charm-lab/Tapebot-Code/TapeBot PCB Files - Spencer/BoardImage.jpg

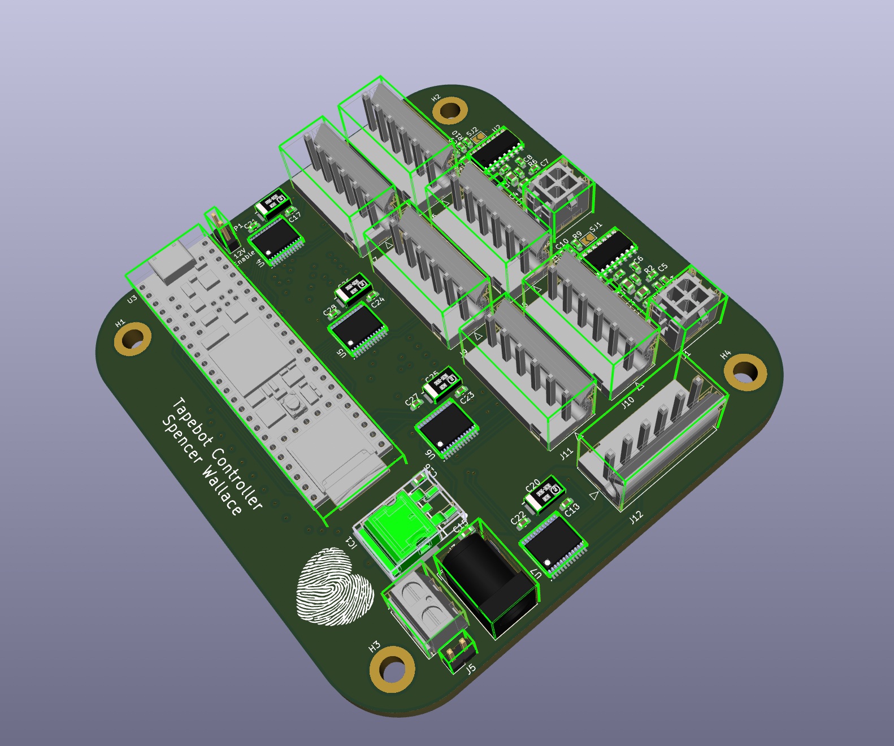
TapeBot PCB Files - Spencer/BoardImage.jpg
