charm-lab/Tapebot-Code/TapeBot PCB Files - Spencer/TapeBot.jpg

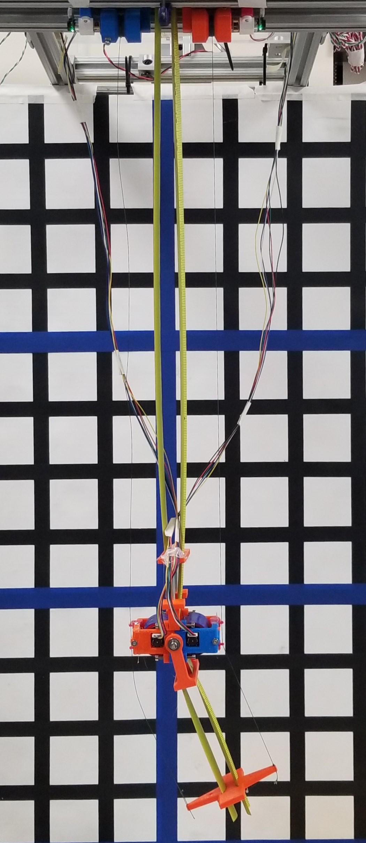
TapeBot PCB Files - Spencer/TapeBot.jpg
