charm-lab/Tapebot-Code/TapeBot PCB Files - Spencer/TapeBotLibraries/DCJ200-10-A-XX-X_REVA/DCJ200-10-A-XX-X_REVA.step

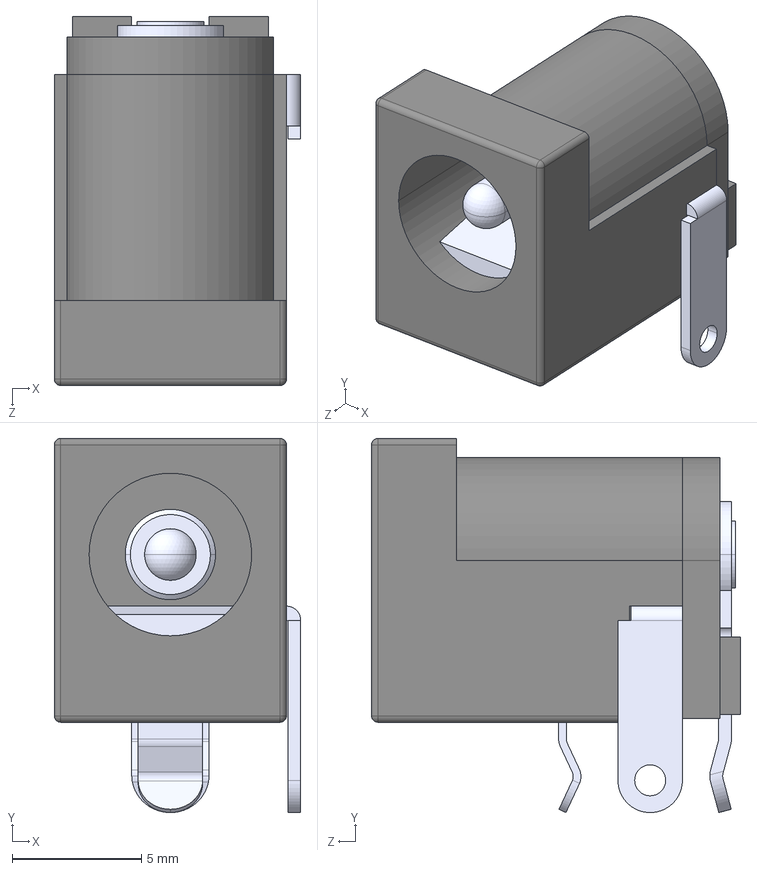
[picture p4: CAD file, 2023-02-14]
TapeBot PCB Files - Spencer/TapeBotLibraries/DCJ200-10-A-XX-X_REVA/DCJ200-10-A-XX-X_REVA.step
9.55 x 14.5 x 14.3 mm
