charm-lab/Tapebot-Code/TapeBot PCB Files - Spencer/TapeBotLibraries/LIB_09-65-2068/09-65-2068/3D/09-65-2068.stp

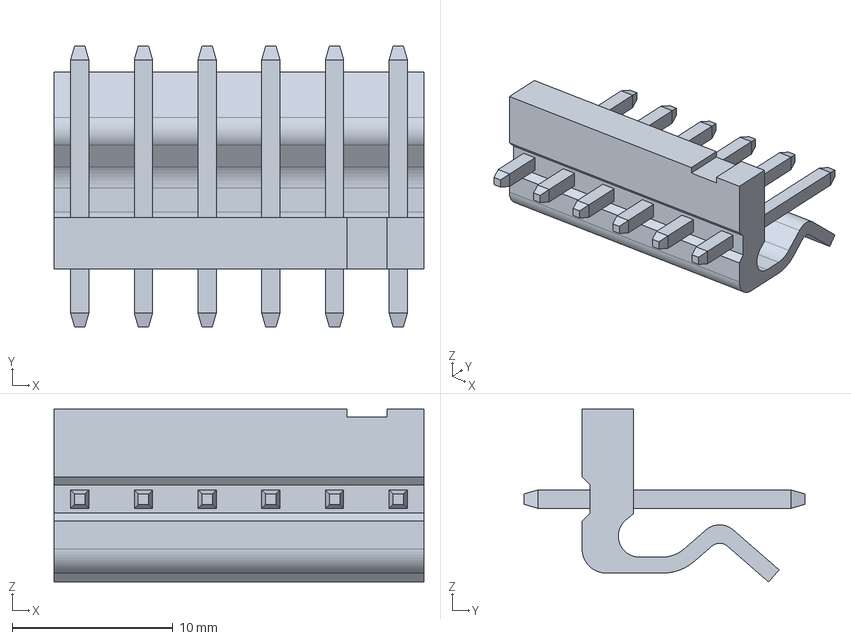
[picture p5: CAD file, 2023-01-29]
TapeBot PCB Files - Spencer/TapeBotLibraries/LIB_09-65-2068/09-65-2068/3D/09-65-2068.stp
23.0 x 17.4 x 10.8 mm
