charm-lab/Tapebot-Code/TapeBot PCB Files - Spencer/TapeBotLibraries/LIB_593D106X9025C2TE3/593D106X9025C2TE3/3D/593D106X9025C2TE3.stp

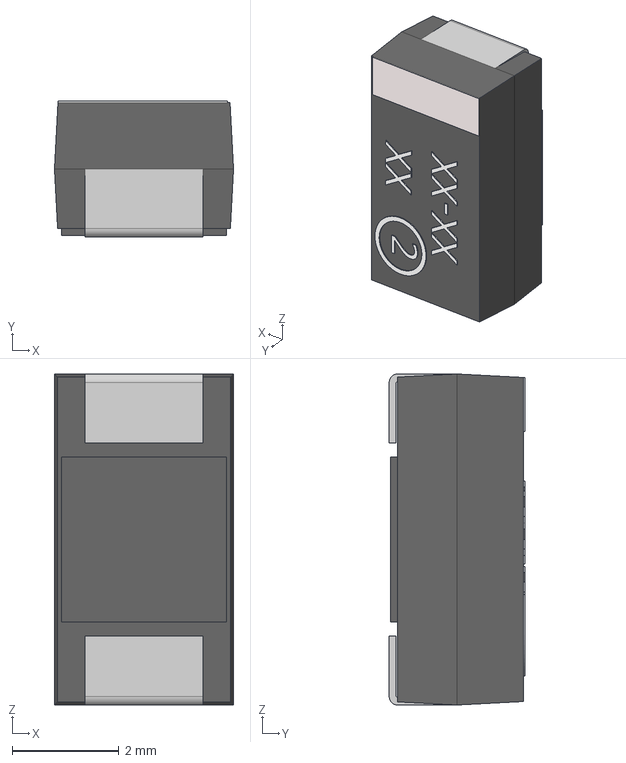
[picture p6: CAD file, 2023-01-29]
TapeBot PCB Files - Spencer/TapeBotLibraries/LIB_593D106X9025C2TE3/593D106X9025C2TE3/3D/593D106X9025C2TE3.stp
3.35 x 2.54 x 6.20 mm
