charm-lab/Tapebot-Code/TapeBot PCB Files - Spencer/TapeBotLibraries/LIB_L7805ABD2T-TR (1)/L7805ABD2T-TR/3D/L7805ABD2T-TR.stp

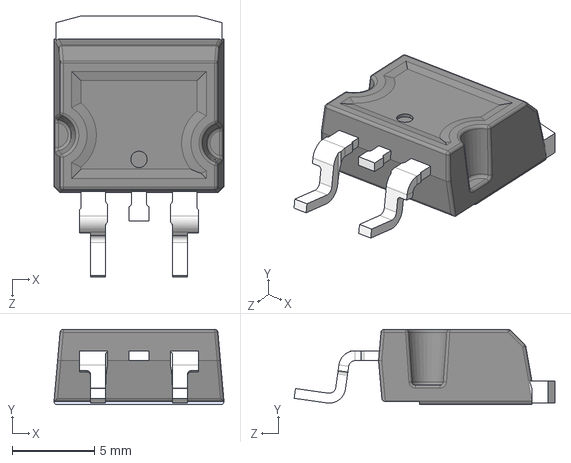
[picture p7: CAD file, 2023-02-14]
TapeBot PCB Files - Spencer/TapeBotLibraries/LIB_L7805ABD2T-TR (1)/L7805ABD2T-TR/3D/L7805ABD2T-TR.stp
10.4 x 4.60 x 15.9 mm
