charm-lab/Tapebot-Code/TapeBot PCB Files - Spencer/TapeBotLibraries/MBRD835LG.STEP

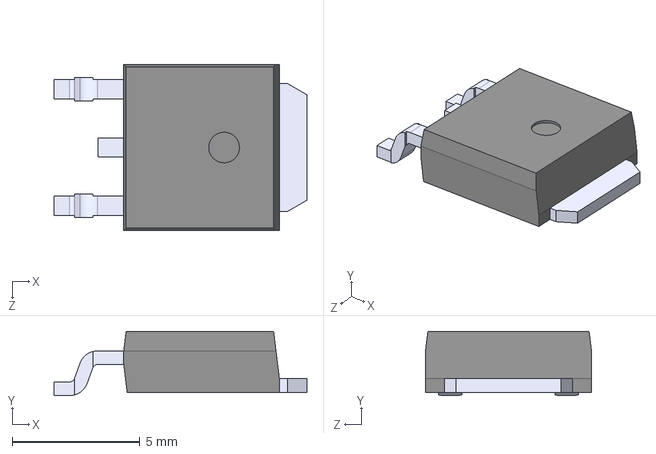
[picture p8: CAD file, 2023-02-14]
TapeBot PCB Files - Spencer/TapeBotLibraries/MBRD835LG.STEP
9.91 x 2.51 x 6.50 mm
