charm-lab/Tapebot-Code/TapeBot PCB Files - Spencer/TapeBotLibraries/MMBT4403_/MMBT4403_.step

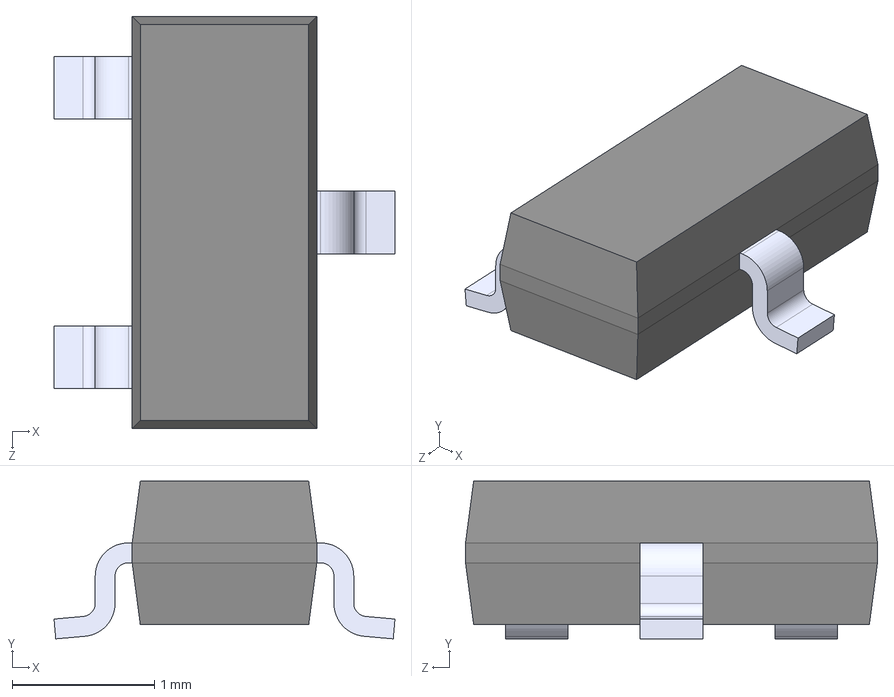
[picture p9: CAD file, 2023-01-29]
TapeBot PCB Files - Spencer/TapeBotLibraries/MMBT4403_/MMBT4403_.step
2.40 x 1.11 x 2.90 mm
