charm-lab/Tapebot-Code/TapeBot PCB Files - Spencer/TapeBotLibraries/TB6612FNG_C_8_EL/TB6612FNG_C_8_EL.step

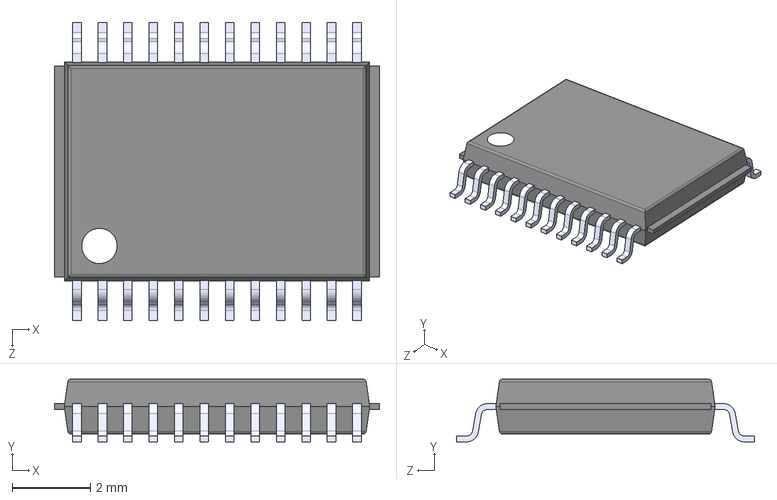
[picture p10: CAD file, 2023-01-29]
TapeBot PCB Files - Spencer/TapeBotLibraries/TB6612FNG_C_8_EL/TB6612FNG_C_8_EL.step
8.30 x 1.60 x 7.60 mm
