charm-lab/Tapebot-Code/TapeBot PCB Files - Spencer/TapeBotLibraries/User Library-SOIC-16-1.STEP

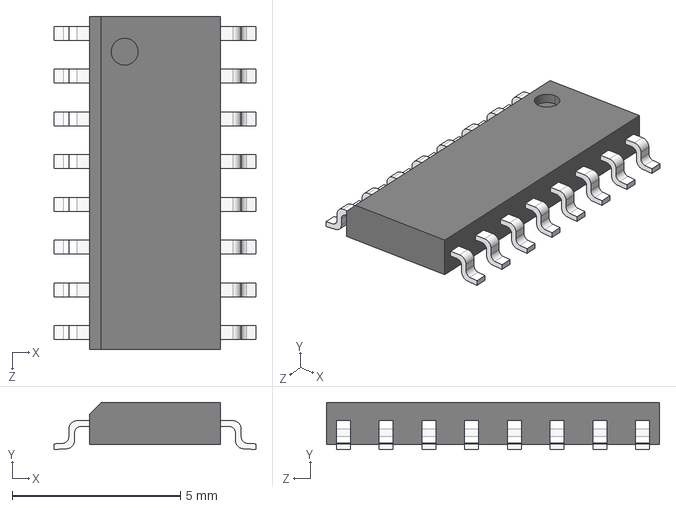
[picture p11: CAD file, 2023-01-29]
TapeBot PCB Files - Spencer/TapeBotLibraries/User Library-SOIC-16-1.STEP
6.00 x 1.40 x 9.90 mm
