charm-lab/Tapebot-Code/TapeBot PCB Files - Spencer/TapeBotLibraries/282837-2/282837-2.step

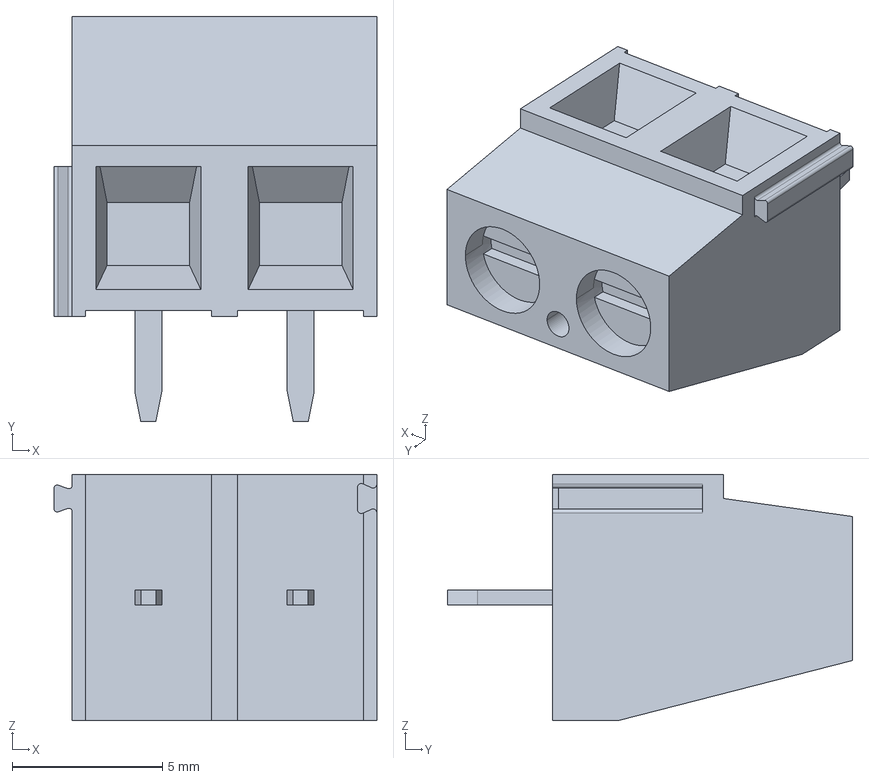
[picture p12: CAD file, 2023-02-14]
TapeBot PCB Files - Spencer/TapeBotLibraries/282837-2/282837-2.step
10.8 x 13.5 x 8.20 mm
