charm-lab/Tapebot-Code/TapeBot PCB Files - Spencer/TapeBotLibraries/LIB_43045-0412 (1)/43045-0412/3D/43045-0412.stp

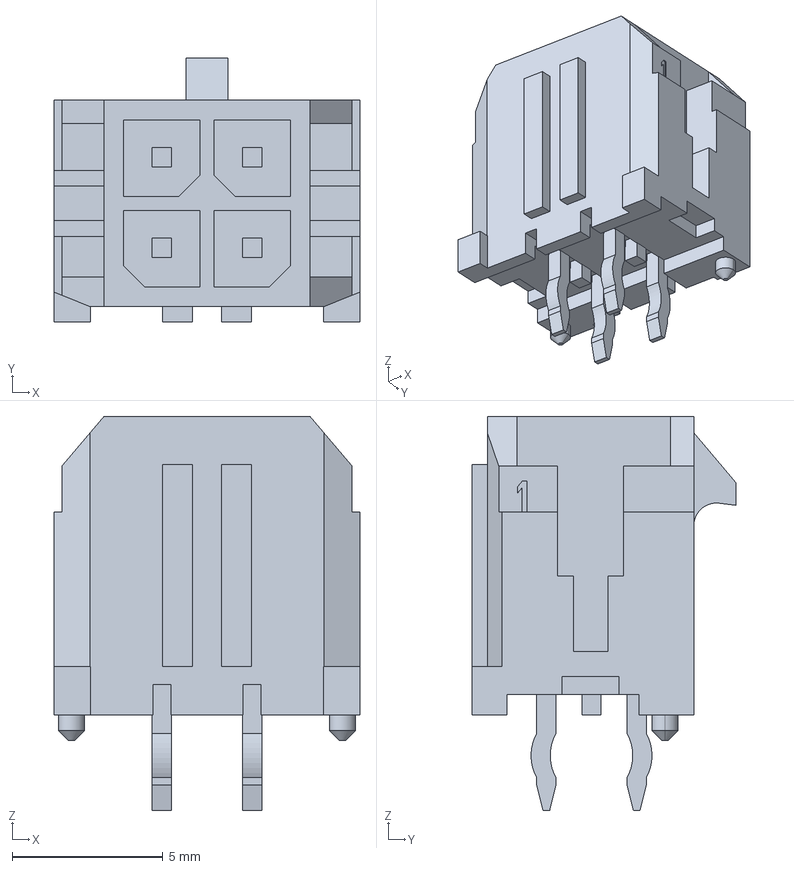
[picture p13: CAD file, 2023-01-29]
TapeBot PCB Files - Spencer/TapeBotLibraries/LIB_43045-0412 (1)/43045-0412/3D/43045-0412.stp
10.2 x 8.77 x 13.1 mm
