charm-lab/Tapebot-Code/(list of files, cad)

Other CAD files:
TapeBot PCB Files - Spencer/TapeBotLibraries/LIB_09-65-2068/09-65-2068/Allegro/hdrv6w80p0x396_1x6_2300x1062x1425p.psm
TapeBot PCB Files - Spencer/TapeBotLibraries/LIB_09-65-2068/09-65-2068/DEHDL/09_65_2068/chips/chips.prt
TapeBot PCB Files - Spencer/TapeBotLibraries/LIB_43045-0412 (1)/43045-0412/Allegro/43045-04yy_121314.psm
TapeBot PCB Files - Spencer/TapeBotLibraries/LIB_43045-0412 (1)/43045-0412/DEHDL/43045_0412/chips/chips.prt
TapeBot PCB Files - Spencer/TapeBotLibraries/LIB_593D106X9025C2TE3/593D106X9025C2TE3/Allegro/cappm6032x280n.psm
TapeBot PCB Files - Spencer/TapeBotLibraries/LIB_593D106X9025C2TE3/593D106X9025C2TE3/DEHDL/593d106x9025c2te3/chips/chips.prt
TapeBot PCB Files - Spencer/TapeBotLibraries/LIB_L7805ABD2T-TR (1)/L7805ABD2T-TR/Allegro/d2pak-stb35nf10t4.psm
TapeBot PCB Files - Spencer/TapeBotLibraries/LIB_L7805ABD2T-TR (1)/L7805ABD2T-TR/DEHDL/l7805abd2t_tr/chips/chips.prt
