charm-lab/Tapebot-Code/(list of files, drawings)

Other design files:
TapeBot PCB Files - Spencer/TapeBotLibraries/LIB_09-65-2068/09-65-2068/Altium/09-65-2068.SchLib
TapeBot PCB Files - Spencer/TapeBotLibraries/LIB_09-65-2068/09-65-2068/Altium/HDRV6W80P0X396_1X6_2300X1062X1425P.PcbLib
TapeBot PCB Files - Spencer/TapeBotLibraries/LIB_593D106X9025C2TE3/593D106X9025C2TE3/Altium/593D106X9025C2TE3.SchLib
TapeBot PCB Files - Spencer/TapeBotLibraries/LIB_593D106X9025C2TE3/593D106X9025C2TE3/Altium/CAPPM6032X280N.PcbLib
TapeBot PCB Files - Spencer/TapeBotLibraries/LIB_L7805ABD2T-TR (1)/L7805ABD2T-TR/Altium/D2PAK-STB35NF10T4.PcbLib
TapeBot PCB Files - Spencer/TapeBotLibraries/LIB_L7805ABD2T-TR (1)/L7805ABD2T-TR/Altium/L7805ABD2T-TR.SchLib
