charm-lab/Tapebot-Code/TapeBot PCB Files - Spencer/TapeBot.kicad_pcb

## KiCad design TapeBot PCB Files - Spencer/TapeBot.kicad_pcb (2023-02-16)

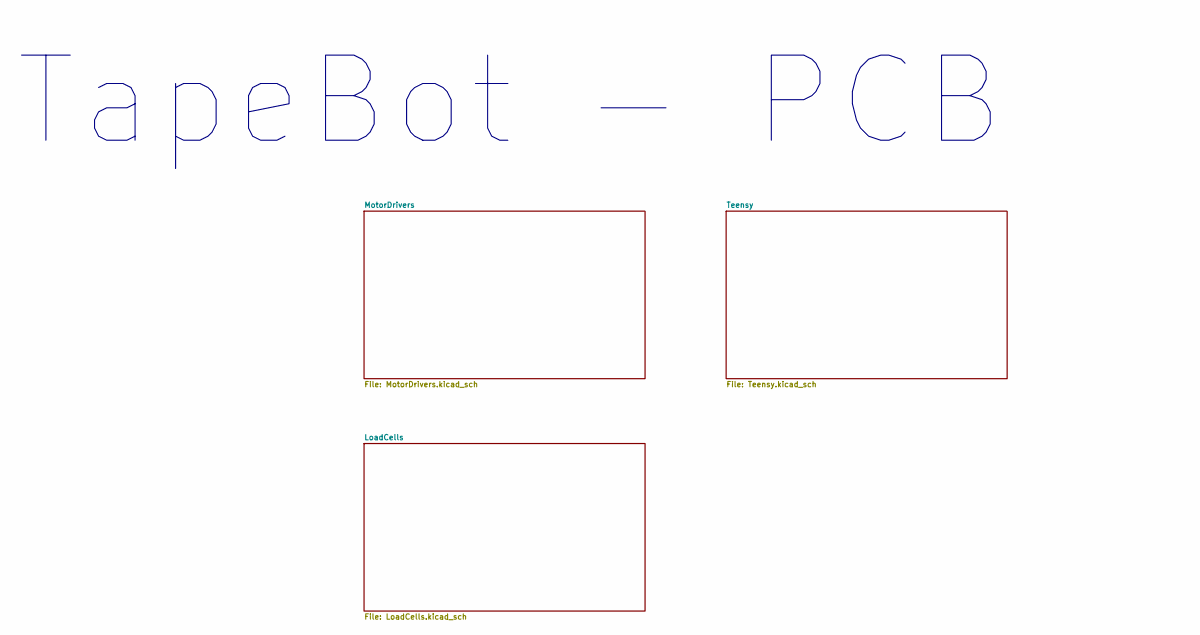
[picture p14: schematic TapeBot.kicad_sch, TapeBot PCB]

Notes on the sheet:
TapeBot - PCB

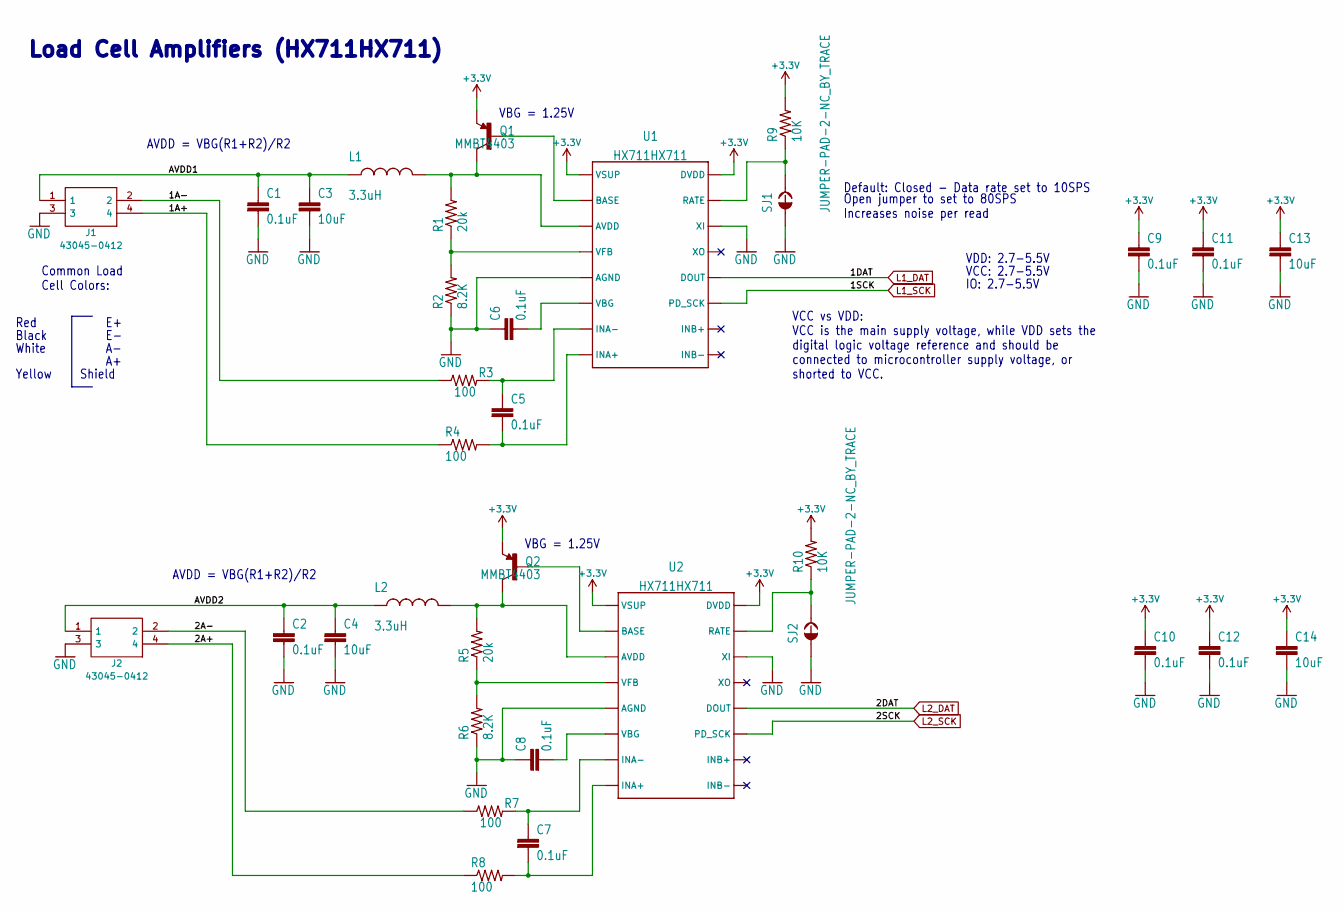
[picture p15: schematic LoadCells.kicad_sch, Load Cells]

Parts:
C1, C2, C5, C6, C7, C8, C9, C10, C11, C12: 0.1uF; C_0603_1608Metric_Pad1.08x0.95mm_HandSolder
C3, C4, C13, C14: 10uF; C_0805_2012Metric_Pad1.18x1.45mm_HandSolder
J1, J2: 43045-0412; 43045-04YY_121314; Mouser Part Number 538-43045-0412
L1, L2: 3.3uH; C_0805_2012Metric_Pad1.18x1.45mm_HandSolder
Q1, Q2: MMBT4403; SOT23-BEC
R1, R5: 20k; C_0603_1608Metric_Pad1.08x0.95mm_HandSolder
R2, R6: 8.2K; C_0603_1608Metric_Pad1.08x0.95mm_HandSolder
R3, R4, R7, R8: 100; C_0603_1608Metric_Pad1.08x0.95mm_HandSolder
R9, R10: 10K; C_0603_1608Metric_Pad1.08x0.95mm_HandSolder
SJ1, SJ2: JUMPER-PAD-2-NC_BY_TRACE; SolderJumper-2_P1.3mm_Open_TrianglePad1.0x1.5mm
U1, U2: HX711HX711; SOP127P600X180-16N

Connections:
+3.3V: C9.1, C10.1, C11.1, C12.1, C13.1, C14.1, Q1.E, Q2.E, R9.2, R10.2, U1.1 (VSUP), U1.16 (DVDD), U2.1 (VSUP), U2.16 (DVDD); also elsewhere on the board
/LoadCells/1A+: J1.4, R4.1
/LoadCells/1A-: J1.2, R3.1
/LoadCells/2A+: J2.4, R8.1
/LoadCells/2A-: J2.2, R7.1
/LoadCells/AVDD1: C1.1, C3.1, J1.1, L1.1
/LoadCells/AVDD2: C2.1, C4.1, J2.1, L2.1
GND: C1.2, C2.2, C3.2, C4.2, C6.1, C8.1, C9.2, C10.2, C11.2, C12.2, C13.2, C14.2, J1.3, J2.3, R2.1, R6.1, SJ1.1, SJ2.1, U1.5 (AGND), U1.14 (XI), U2.5 (AGND), U2.14 (XI); also elsewhere on the board
L1_DAT: U1.12 (DOUT); also elsewhere on the board
L1_SCK: U1.11 (PD_SCK); also elsewhere on the board
L2_DAT: U2.12 (DOUT); also elsewhere on the board
L2_SCK: U2.11 (PD_SCK); also elsewhere on the board
unnamed: C5.1, R3.2, U1.7 (INA-)
unnamed: C5.2, R4.2, U1.8 (INA+)
unnamed: C6.2, U1.6 (VBG)
unnamed: C7.1, R7.2, U2.7 (INA-)
unnamed: C7.2, R8.2, U2.8 (INA+)
unnamed: C8.2, U2.6 (VBG)
unnamed: L1.2, Q1.C, R1.2, U1.3 (AVDD)
unnamed: L2.2, Q2.C, R5.2, U2.3 (AVDD)
unnamed: Q1.B, U1.2 (BASE)
unnamed: Q2.B, U2.2 (BASE)
unnamed: R1.1, R2.2, U1.4 (VFB)
unnamed: R5.1, R6.2, U2.4 (VFB)
unnamed: R9.1, SJ1.2, U1.15 (RATE)
unnamed: R10.1, SJ2.2, U2.15 (RATE)

Notes on the sheet:
White
VBG = 1.25V
Shield
Yellow
Black
VDD: 2.7-5.5V
Load Cell Amplifiers (HX711HX711)
Common Load Cell Colors:
VCC vs VDD: VCC is the main supply voltage, while VDD sets the digital logic voltage reference and should be connected to microcontroller supply voltage, or shorted to VCC.
VCC: 2.7-5.5V
AVDD = VBG(R1+R2)/R2
Red
Default: Closed - Data rate set to 10SPS
Open jumper to set to 80SPS Increases noise per read
IO: 2.7-5.5V

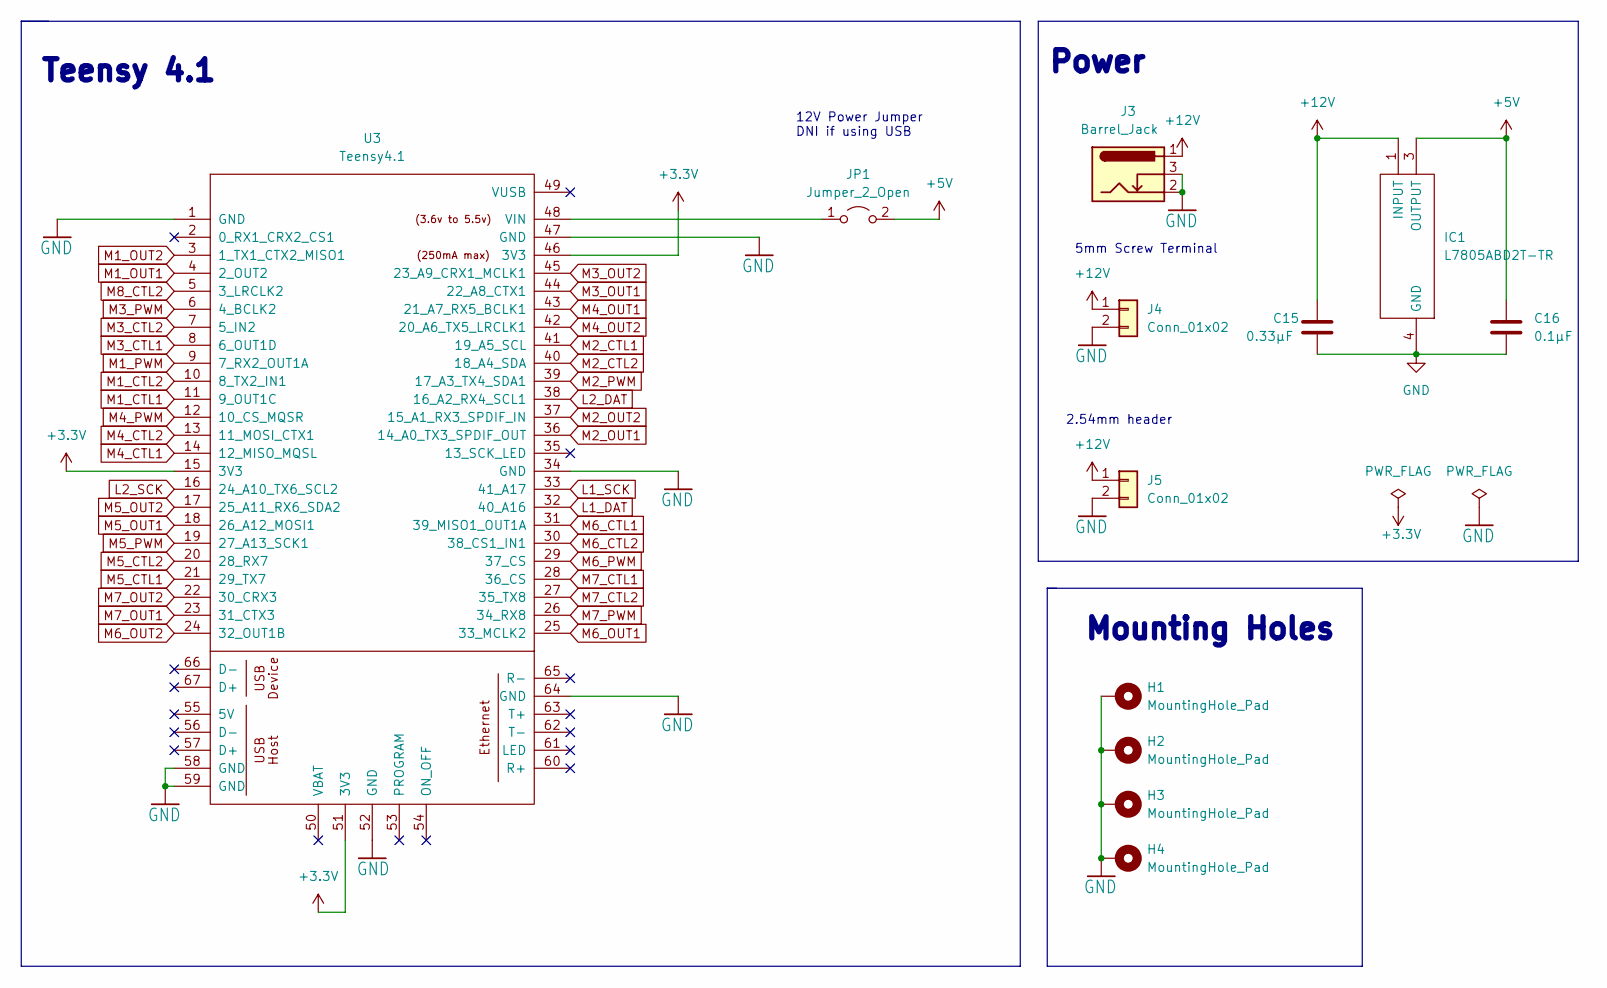
[picture p16: schematic Teensy.kicad_sch]

Parts:
C15: 0.33µF; C_0805_2012Metric_Pad1.18x1.45mm_HandSolder
C16: 0.1µF; C_0805_2012Metric_Pad1.18x1.45mm_HandSolder
H1, H2, H3, H4: MountingHole_Pad; MountingHole_4.3mm_M4_DIN965_Pad
IC1: L7805ABD2T-TR; D2PAK-STB35NF10T4; Mouser Part Number 511-L7805ABD2T-TR
J3: Barrel_Jack; BarrelJack_GCT_DCJ200-10-A_Horizontal
J4: Conn_01x02; TE_282837-2
J5: Conn_01x02; PinHeader_1x02_P2.54mm_Vertical
JP1: Jumper_2_Open; PinHeader_1x02_P2.54mm_Vertical
U3: Teensy4.1; Teensy41

Connections:
+3.3V: U3.15 (3V3), U3.46 (3V3), U3.51 (3V3); also elsewhere on the board
+5V: C16.1, IC1.3 (OUTPUT), JP1.2 (B)
+12V: C15.1, IC1.1 (INPUT), J3.1, J4.1, J5.1; also elsewhere on the board
GND: C15.2, C16.2, H1.1, H2.1, H3.1, H4.1, IC1.4 (GND), J3.2, J3.3, J4.2, J5.2, U3.1 (GND), U3.34 (GND), U3.47 (GND), U3.52 (GND), U3.58 (GND), U3.59 (GND), U3.64 (GND); also elsewhere on the board
L1_DAT: U3.32 (40_A16); also elsewhere on the board
L1_SCK: U3.33 (41_A17); also elsewhere on the board
L2_DAT: U3.38 (16_A2_RX4_SCL1); also elsewhere on the board
L2_SCK: U3.16 (24_A10_TX6_SCL2); also elsewhere on the board
M1_CTL1: U3.11 (9_OUT1C); also elsewhere on the board
M1_CTL2: U3.10 (8_TX2_IN1); also elsewhere on the board
M1_OUT1: U3.4 (2_OUT2); also elsewhere on the board
M1_OUT2: U3.3 (1_TX1_CTX2_MISO1); also elsewhere on the board
M1_PWM: U3.9 (7_RX2_OUT1A); also elsewhere on the board
M2_CTL1: U3.41 (19_A5_SCL); also elsewhere on the board
M2_CTL2: U3.40 (18_A4_SDA); also elsewhere on the board
M2_OUT1: U3.36 (14_A0_TX3_SPDIF_OUT); also elsewhere on the board
M2_OUT2: U3.37 (15_A1_RX3_SPDIF_IN); also elsewhere on the board
M2_PWM: U3.39 (17_A3_TX4_SDA1); also elsewhere on the board
M3_CTL1: U3.8 (6_OUT1D); also elsewhere on the board
M3_CTL2: U3.7 (5_IN2); also elsewhere on the board
M3_OUT1: U3.44 (22_A8_CTX1); also elsewhere on the board
M3_OUT2: U3.45 (23_A9_CRX1_MCLK1); also elsewhere on the board
M3_PWM: U3.6 (4_BCLK2); also elsewhere on the board
M4_CTL1: U3.14 (12_MISO_MQSL); also elsewhere on the board
M4_CTL2: U3.13 (11_MOSI_CTX1); also elsewhere on the board
M4_OUT1: U3.43 (21_A7_RX5_BCLK1); also elsewhere on the board
M4_OUT2: U3.42 (20_A6_TX5_LRCLK1); also elsewhere on the board
M4_PWM: U3.12 (10_CS_MQSR); also elsewhere on the board
M5_CTL1: U3.21 (29_TX7); also elsewhere on the board
M5_CTL2: U3.20 (28_RX7); also elsewhere on the board
M5_OUT1: U3.18 (26_A12_MOSI1); also elsewhere on the board
M5_OUT2: U3.17 (25_A11_RX6_SDA2); also elsewhere on the board
M5_PWM: U3.19 (27_A13_SCK1); also elsewhere on the board
M6_CTL1: U3.31 (39_MISO1_OUT1A); also elsewhere on the board
M6_CTL2: U3.30 (38_CS1_IN1); also elsewhere on the board
M6_OUT1: U3.25 (33_MCLK2); also elsewhere on the board
M6_OUT2: U3.24 (32_OUT1B); also elsewhere on the board
M6_PWM: U3.29 (37_CS); also elsewhere on the board
M7_CTL1: U3.28 (36_CS); also elsewhere on the board
M7_CTL2: U3.27 (35_TX8); also elsewhere on the board
M7_OUT1: U3.23 (31_CTX3); also elsewhere on the board
M7_OUT2: U3.22 (30_CRX3); also elsewhere on the board
M7_PWM: U3.26 (34_RX8); also elsewhere on the board
M8_CTL2: U3.5 (3_LRCLK2)
unnamed: JP1.1 (A), U3.48 (VIN)

Notes on the sheet:
5mm Screw Terminal
12V Power Jumper DNI if using USB
2.54mm header
Teensy 4.1
Power
Mounting Holes

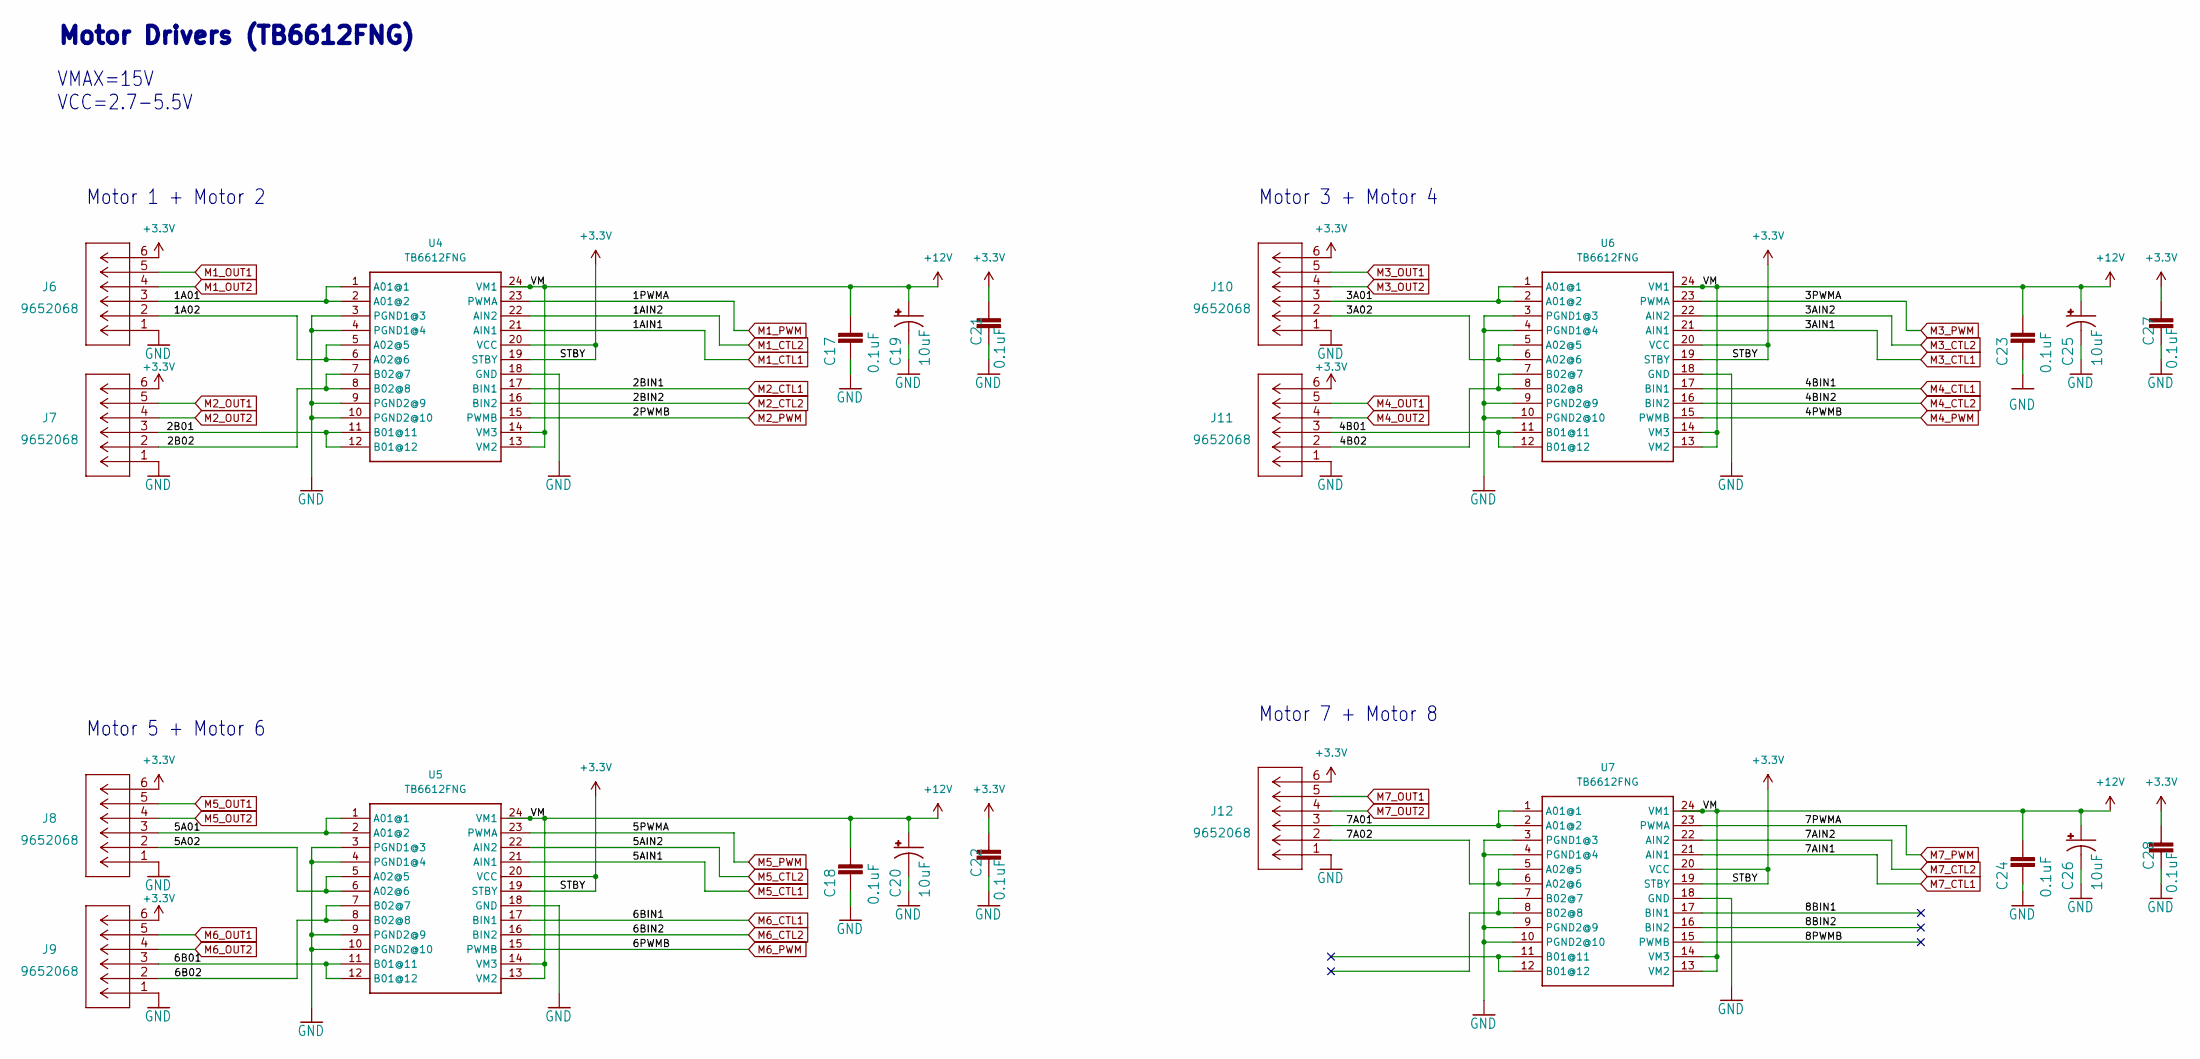
[picture p17: schematic MotorDrivers.kicad_sch]

Parts:
C17, C18, C21, C22, C23, C24, C27, C28: 0.1uF; C_0603_1608Metric_Pad1.08x0.95mm_HandSolder
C19, C20, C25, C26: 10uF; CAPPM6032X280N
J6, J7, J8, J9, J10, J11, J12: 9652068
U4, U5, U6, U7: TB6612FNG; SOP65P760X160-24N

Connections:
+3.3V: C21.1, C22.1, C27.1, C28.1, J6.6, J7.6, J8.6, J9.6, J10.6, J11.6, J12.6, U4.19 (STBY), U4.20 (VCC), U5.19 (STBY), U5.20 (VCC), U6.19 (STBY), U6.20 (VCC), U7.19 (STBY), U7.20 (VCC); also elsewhere on the board
+12V: C17.1, C18.1, C19.A (+), C20.A (+), C23.1, C24.1, C25.A (+), C26.A (+), U4.13 (VM2), U4.14 (VM3), U4.24 (VM1), U5.13 (VM2), U5.14 (VM3), U5.24 (VM1), U6.13 (VM2), U6.14 (VM3), U6.24 (VM1), U7.13 (VM2), U7.14 (VM3), U7.24 (VM1); also elsewhere on the board
/MotorDrivers/1A01: J6.3, U4.1 (A01@1), U4.2 (A01@2)
/MotorDrivers/1A02: J6.2, U4.5 (A02@5), U4.6 (A02@6)
/MotorDrivers/2B01: J7.3, U4.11 (B01@11), U4.12 (B01@12)
/MotorDrivers/2B02: J7.2, U4.7 (B02@7), U4.8 (B02@8)
/MotorDrivers/3A01: J10.3, U6.1 (A01@1), U6.2 (A01@2)
/MotorDrivers/3A02: J10.2, U6.5 (A02@5), U6.6 (A02@6)
/MotorDrivers/4B01: J11.3, U6.11 (B01@11), U6.12 (B01@12)
/MotorDrivers/4B02: J11.2, U6.7 (B02@7), U6.8 (B02@8)
/MotorDrivers/5A01: J8.3, U5.1 (A01@1), U5.2 (A01@2)
/MotorDrivers/5A02: J8.2, U5.5 (A02@5), U5.6 (A02@6)
/MotorDrivers/6B01: J9.3, U5.11 (B01@11), U5.12 (B01@12)
/MotorDrivers/6B02: J9.2, U5.7 (B02@7), U5.8 (B02@8)
/MotorDrivers/7A01: J12.3, U7.1 (A01@1), U7.2 (A01@2)
/MotorDrivers/7A02: J12.2, U7.5 (A02@5), U7.6 (A02@6)
/MotorDrivers/8BIN1: U7.17 (BIN1)
/MotorDrivers/8BIN2: U7.16 (BIN2)
/MotorDrivers/8PWMB: U7.15 (PWMB)
GND: C17.2, C18.2, C19.C (-), C20.C (-), C21.2, C22.2, C23.2, C24.2, C25.C (-), C26.C (-), C27.2, C28.2, J6.1, J7.1, J8.1, J9.1, J10.1, J11.1, J12.1, U4.3 (PGND1@3), U4.4 (PGND1@4), U4.9 (PGND2@9), U4.10 (PGND2@10), U4.18 (GND), U5.3 (PGND1@3), U5.4 (PGND1@4), U5.9 (PGND2@9), U5.10 (PGND2@10), U5.18 (GND), U6.3 (PGND1@3), U6.4 (PGND1@4), U6.9 (PGND2@9), U6.10 (PGND2@10), U6.18 (GND), U7.3 (PGND1@3), U7.4 (PGND1@4), U7.9 (PGND2@9), U7.10 (PGND2@10), U7.18 (GND); also elsewhere on the board
M1_CTL1: U4.21 (AIN1); also elsewhere on the board
M1_CTL2: U4.22 (AIN2); also elsewhere on the board
M1_OUT1: J6.5; also elsewhere on the board
M1_OUT2: J6.4; also elsewhere on the board
M1_PWM: U4.23 (PWMA); also elsewhere on the board
M2_CTL1: U4.17 (BIN1); also elsewhere on the board
M2_CTL2: U4.16 (BIN2); also elsewhere on the board
M2_OUT1: J7.5; also elsewhere on the board
M2_OUT2: J7.4; also elsewhere on the board
M2_PWM: U4.15 (PWMB); also elsewhere on the board
M3_CTL1: U6.21 (AIN1); also elsewhere on the board
M3_CTL2: U6.22 (AIN2); also elsewhere on the board
M3_OUT1: J10.5; also elsewhere on the board
M3_OUT2: J10.4; also elsewhere on the board
M3_PWM: U6.23 (PWMA); also elsewhere on the board
M4_CTL1: U6.17 (BIN1); also elsewhere on the board
M4_CTL2: U6.16 (BIN2); also elsewhere on the board
M4_OUT1: J11.5; also elsewhere on the board
M4_OUT2: J11.4; also elsewhere on the board
M4_PWM: U6.15 (PWMB); also elsewhere on the board
M5_CTL1: U5.21 (AIN1); also elsewhere on the board
M5_CTL2: U5.22 (AIN2); also elsewhere on the board
M5_OUT1: J8.5; also elsewhere on the board
M5_OUT2: J8.4; also elsewhere on the board
M5_PWM: U5.23 (PWMA); also elsewhere on the board
M6_CTL1: U5.17 (BIN1); also elsewhere on the board
M6_CTL2: U5.16 (BIN2); also elsewhere on the board
M6_OUT1: J9.5; also elsewhere on the board
M6_OUT2: J9.4; also elsewhere on the board
M6_PWM: U5.15 (PWMB); also elsewhere on the board
M7_CTL1: U7.21 (AIN1); also elsewhere on the board
M7_CTL2: U7.22 (AIN2); also elsewhere on the board
M7_OUT1: J12.5; also elsewhere on the board
M7_OUT2: J12.4; also elsewhere on the board
M7_PWM: U7.23 (PWMA); also elsewhere on the board

Notes on the sheet:
VMAX=15V VCC=2.7-5.5V
Motor 7 + Motor 8
Motor 5 + Motor 6
Motor 3 + Motor 4
Motor Drivers (TB6612FNG)
Motor 1 + Motor 2

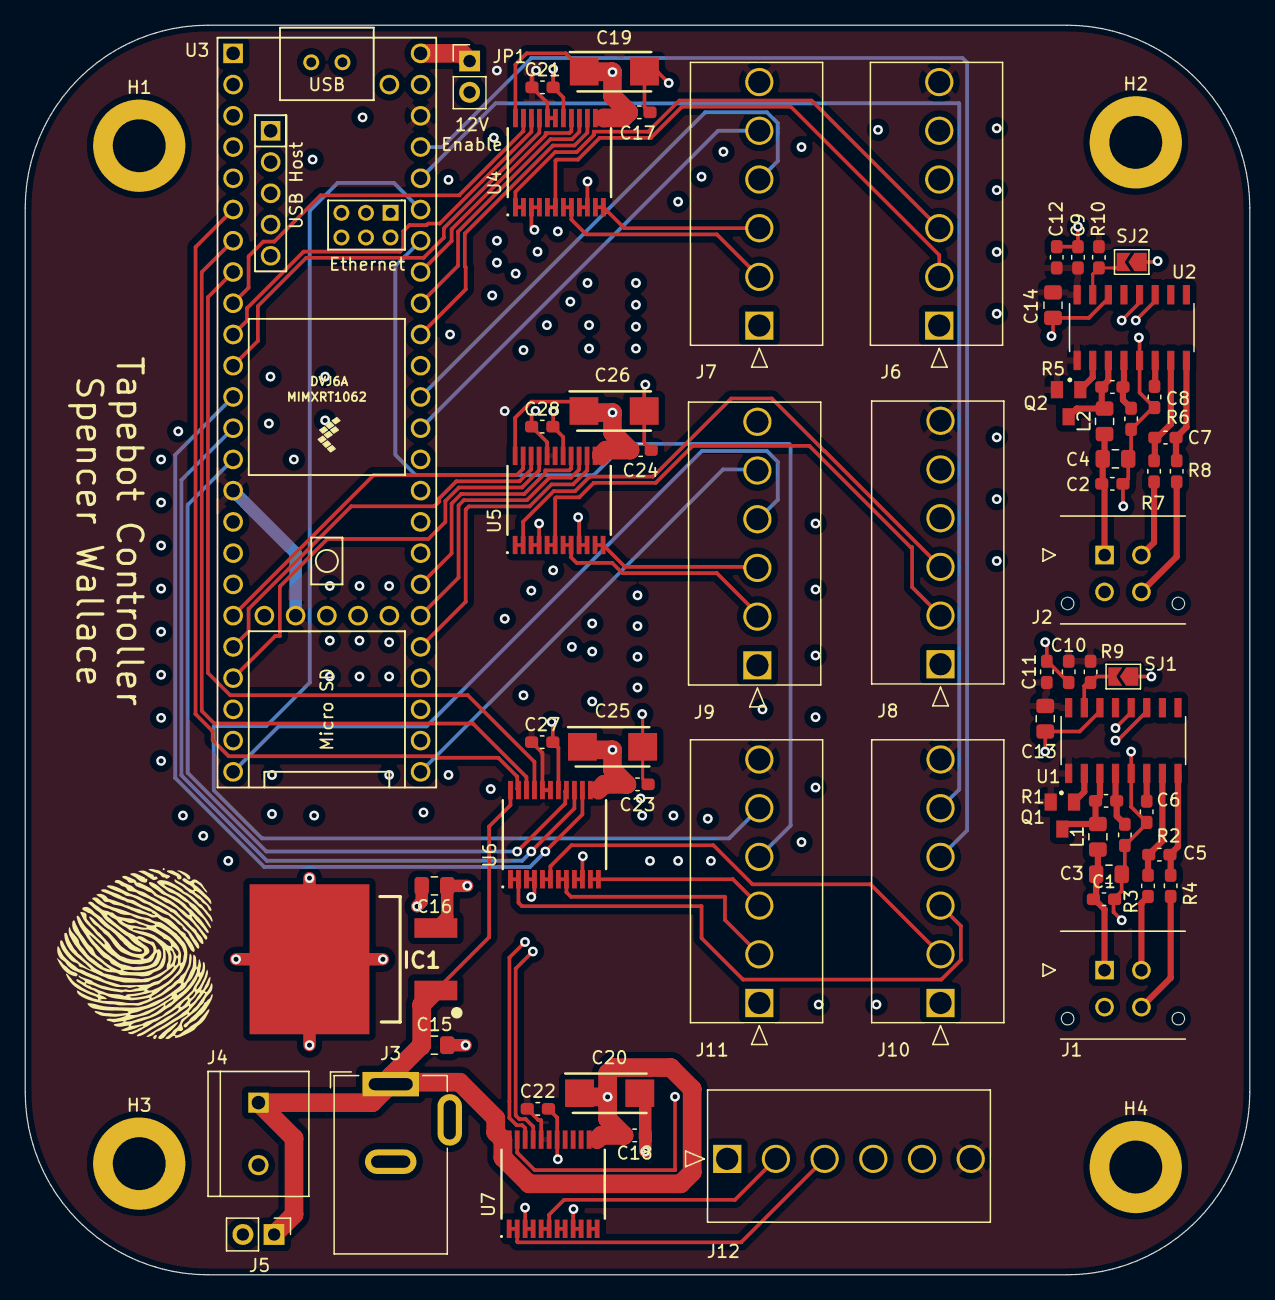
[picture p18: board TapeBot.kicad_pcb from above]

Board: 4 copper layers, 99.6 x 101.6 mm, 69 parts (0 on the bottom side), 78 nets.
