charm-lab/Tapebot-Code/Bending Test Setup - Frances/Communication.py

# Reading and Saving Serial Data from an Arduino and a Force Sensor 
# Written by: Frances Raphael fraphael@stanford.edu

import serial
import datetime
import csv
import os
import sys
import glob
import threading
import numpy as np
from scipy import signal
# CONSTANTS
RUNTIME_LENGTH = 30
 # second
PATH_DEST = "/home/frances/Tapebot-Code/TapeBotTestSetup"
PORT_NAME1 = "/dev/ttyS8"
PORT_NAME2 = "/dev/ttyS10"
BAUD_RATE = 9600
# DIRECTORY
fileName = str(datetime.datetime.now())[0:16]  # default name is date and time
fileName = ((fileName.replace('/', '_')).replace(' ', '_')).replace(':', '-')
p = PATH_DEST + fileName+'/'
if not (os.path.exists(p)):
    os.makedirs(p)
    print("New directory created: %s" % fileName)

# Check the device connections for Windows or Linix
if sys.platform.startswith('win'):
    ports = ['COM%s' % (i + 1) for i in range(256)]
elif sys.platform.startswith('linux') or sys.platform.startswith('cygwin'):
    # this excludes your current terminal "/dev/tty"
    ports = glob.glob('/dev/tty[A-Za-z]*')
elif sys.platform.startswith('darwin'):
    ports = glob.glob('/dev/tty.*')
else:
    raise EnvironmentError('Unsupported platform')
result = []
for port in ports:
    try:
        s = serial.Serial(port)
        s.close()
        result.append(port)
    except (OSError, serial.SerialException):
        pass
print(result)


# Functions to run when setting up the threads
def arduinoClass():
    global arduino
    arduino = serial.Serial(port=PORT_NAME1, baudrate=BAUD_RATE, timeout=.1)
    # clear the old data
    arduino.flushInput()
    arduino.flushOutput()
    # print(str(datetime.datetime.now()))
    # print("Arduino On!")


# def forcesensorClass():
#     global force
#     force = serial.Serial(port=PORT_NAME2, baudrate=BAUD_RATE, timeout=.1)
#     # clear the old data
#     force.flushInput()
#     force.flushOutput()
#     # print(str(datetime.datetime.now()))
#     # print("Force On!")


# Starting up the Threads
thread_one = threading.Thread(target=arduinoClass, args=())
#thread_two = threading.Thread(target=forcesensorClass, args=())

# Start the threads at the same time
thread_one.start()
#thread_two.start()

# Join the Threads together
thread_one.join()
#thread_two.join()

# print("Done setting up the threads!")


f = open(p + 'raw_' + fileName + '.csv', 'w+', encoding='UTF8', newline='')
writer = csv.writer(f)
# Read serial data and save in CSV
endTime = datetime.datetime.now() + datetime.timedelta(seconds=RUNTIME_LENGTH)
while datetime.datetime.now() < endTime:
    arduinoData = arduino.readline().decode("utf-8").strip().split()
    #forceData = force.readline().decode("utf-8").strip().split()
    #print(arduinoData)
    #print(arduino.readline().decode("utf-8").strip().split())

    if len(arduinoData) >= 12: # and len(forceData) >= 1:
        print([arduinoData[2], arduinoData[5], arduinoData[9], arduinoData[12]])
        #Write the data into separate rows
        writer.writerow([arduinoData[2], arduinoData[5],
                         arduinoData[9], arduinoData[12]])
f.close()
