charm-lab/Tapebot-Code/(commit log)

2023-01-24 Added TapeBot PCB Files
    [LoadCells.kicad_sch, MotorDrivers.kicad_sch, TapeBot.kicad_pcb, TapeBot.kicad_sch, Teensy.kicad_sch]
2023-01-29 fixed footprints and symbols
    [LoadCells.kicad_sch, MotorDrivers.kicad_sch, TB6612FNG_C_8_EL.step, TapeBot.kicad_sch, Teensy.kicad_sch, Teensy_4.0_Assembly.STEP]
2023-01-29 finished motor driver schematic and load cell schematic
    [43045-0412.stp, 43045-04yy_121314.psm, EDI2CAP.CFG, LoadCells.kicad_sch, MotorDrivers.kicad_sch, TapeBot.kicad_sch, Teensy.kicad_sch, chips.prt]
2023-01-29 added label
    [Teensy.kicad_sch]
2023-01-29 (mostly) finished schematic
    [LoadCells.kicad_sch, MotorDrivers.kicad_sch, Teensy.kicad_sch]
2023-01-29 fixed footprints and 3d models
    [09-65-2068.SchLib, 09-65-2068.stp, 593D106X9025C2TE3.SchLib, 593D106X9025C2TE3.stp, CAPPM6032X280N.PcbLib, EDI2CAP.CFG, HDRV6W80P0X396_1X6_2300X1062X1425P.PcbLib, LoadCells.kicad_sch]
2023-02-07 arranged board
    [LoadCells.kicad_sch, MotorDrivers.kicad_sch, TapeBot.kicad_pcb, TapeBot.kicad_sch, Teensy.kicad_sch]
2023-02-14 First layout of PCB finished
    [282837-2.step, D2PAK-STB35NF10T4.PcbLib, DCJ200-10-A-XX-X_REVA.step, EDI2CAP.CFG, L7805ABD2T-TR.SchLib, L7805ABD2T-TR.stp, MBRD835LG.STEP, MotorDrivers.kicad_sch]
2023-02-16 Fixed Voltage Regulator placement, Added ground vias
    [TapeBot.kicad_pcb]
2023-02-16 Fixed some footprints
    [LoadCells.kicad_sch, TapeBot.kicad_pcb, TapeBot.kicad_sch]
2023-02-16 Final Commit
    [TapeBot.kicad_pcb]
2023-05-09 Update main.cpp
    Specified that "Physical constants for rollers, spools, etc" in the code are in millimeters
2024-12-09 Reorganized and renamed files
    [09-65-2068.SchLib, 09-65-2068.stp, 282837-2.step, 43045-0412.stp, 43045-04yy_121314.psm, 593D106X9025C2TE3.SchLib, 593D106X9025C2TE3.stp, CAPPM6032X280N.PcbLib]
